ArneGleason/clive-dispenser/renders/cutaway_open.png

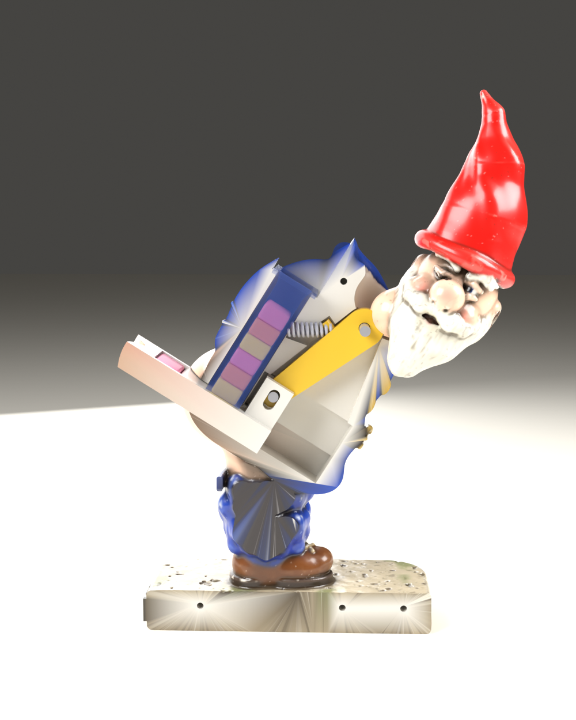
renders/cutaway_open.png
