ArneGleason/clive-dispenser/renders/cutaway_rest.png

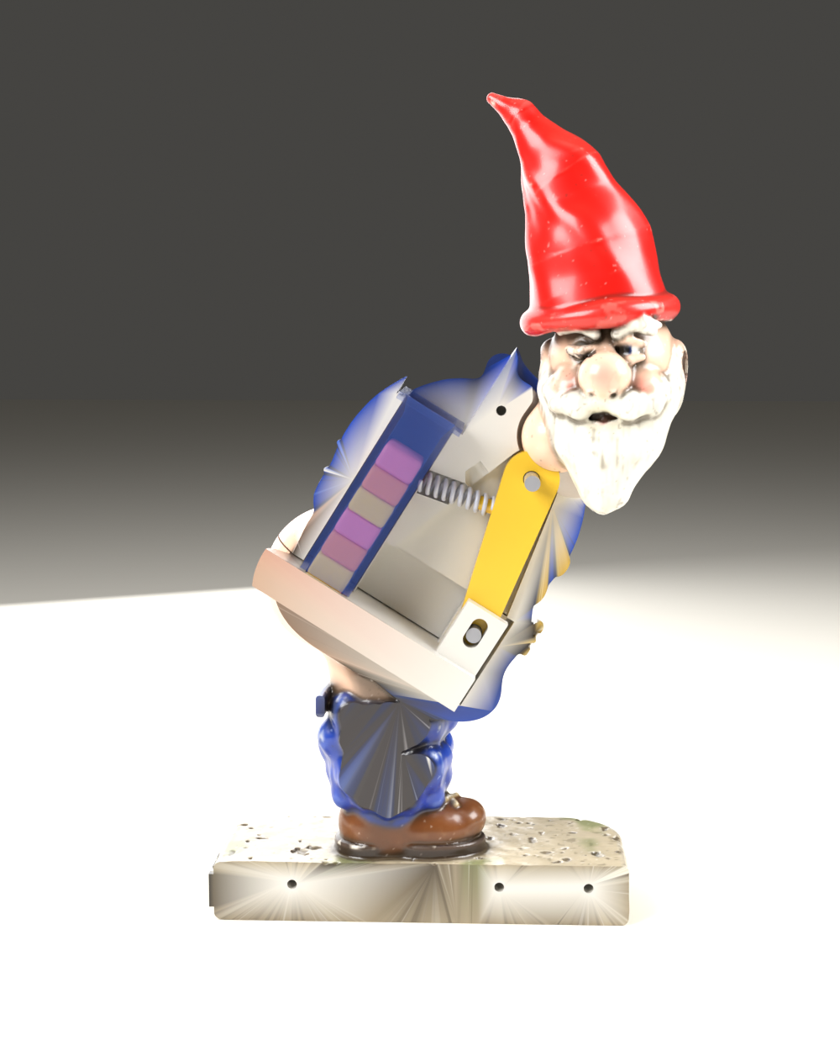
renders/cutaway_rest.png
