ArneGleason/clive-dispenser/renders/face.png

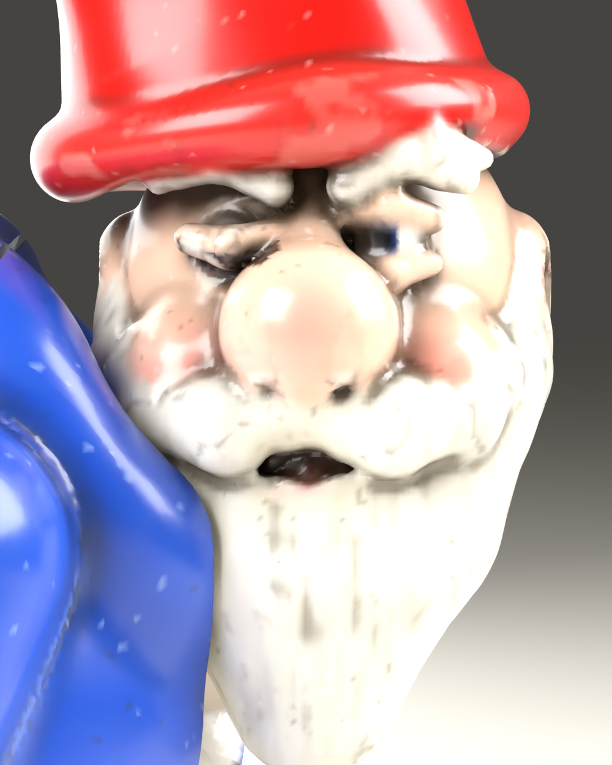
renders/face.png
