ArneGleason/clive-dispenser/renders/front_closed.png

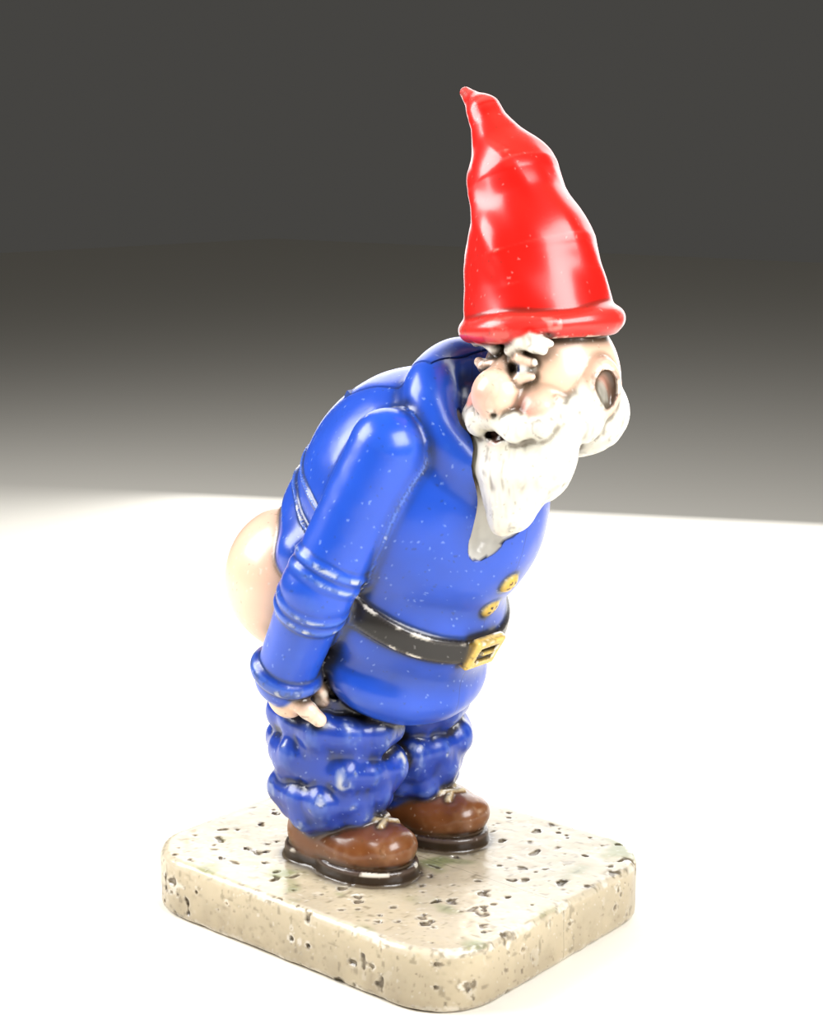
renders/front_closed.png
