ArneGleason/clive-dispenser/renders/hero_closed.png

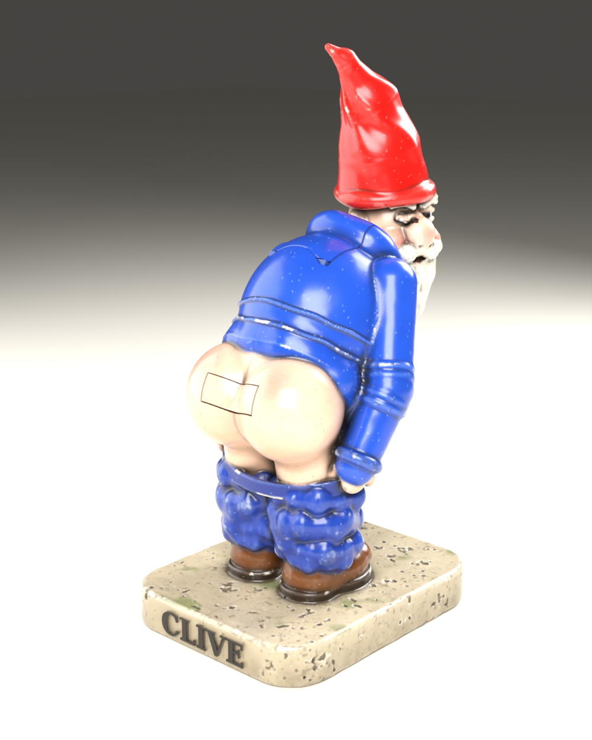
renders/hero_closed.png
