ArneGleason/clive-dispenser/renders/hero_open.png

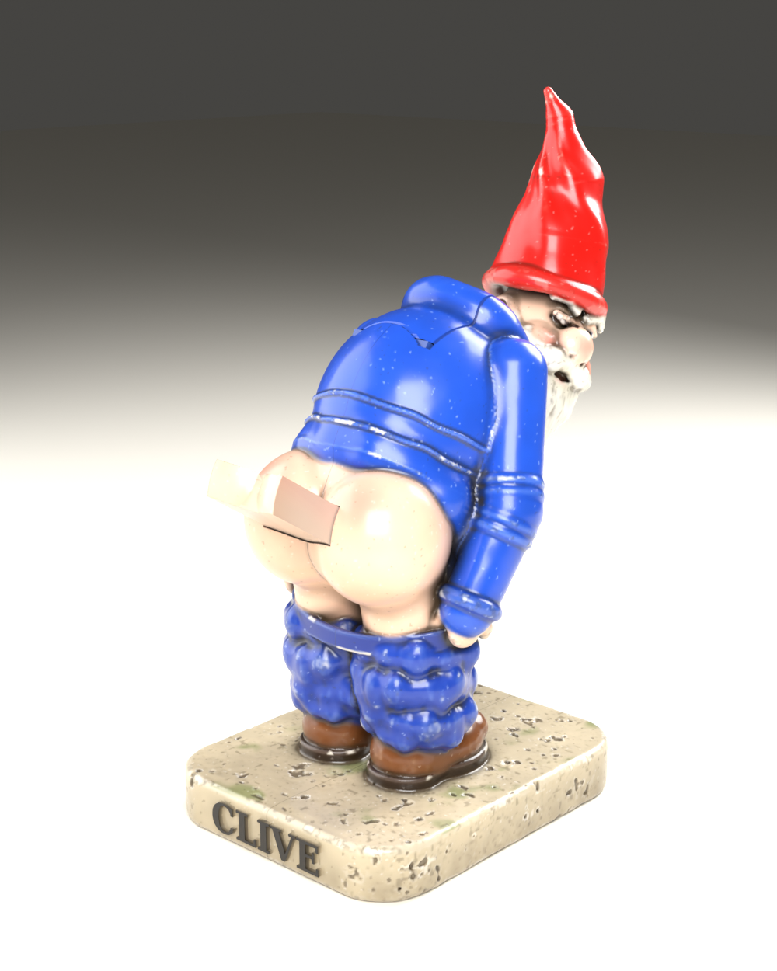
renders/hero_open.png
