ArneGleason/clive-dispenser/renders/plinth.png

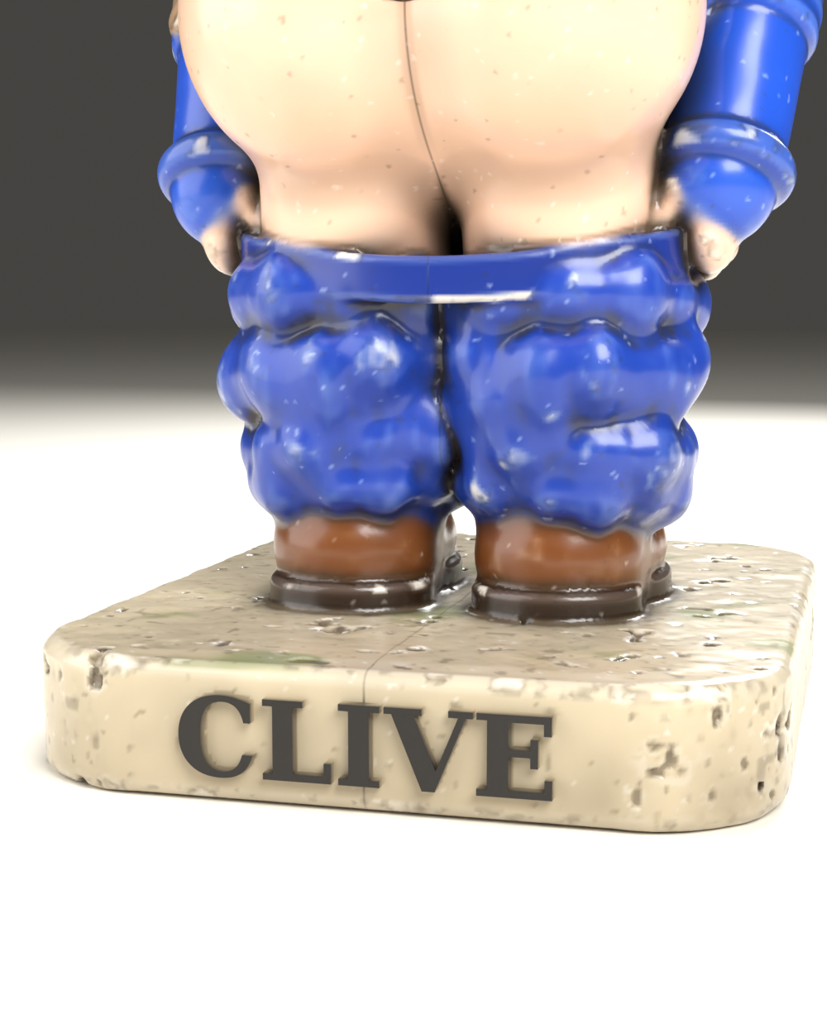
renders/plinth.png
