ArneGleason/clive-dispenser/assets/clive_text.stl

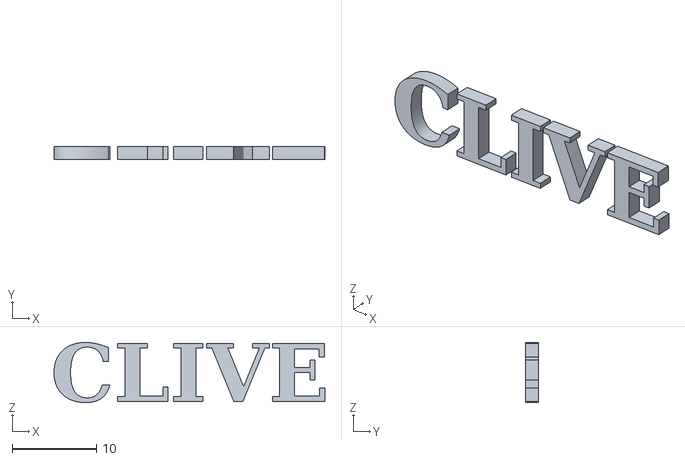
[picture p9: CAD file, 2026-10-11]
assets/clive_text.stl
32.2 x 1.60 x 7.15
