ArneGleason/clive-dispenser/colour/full/head.3mf

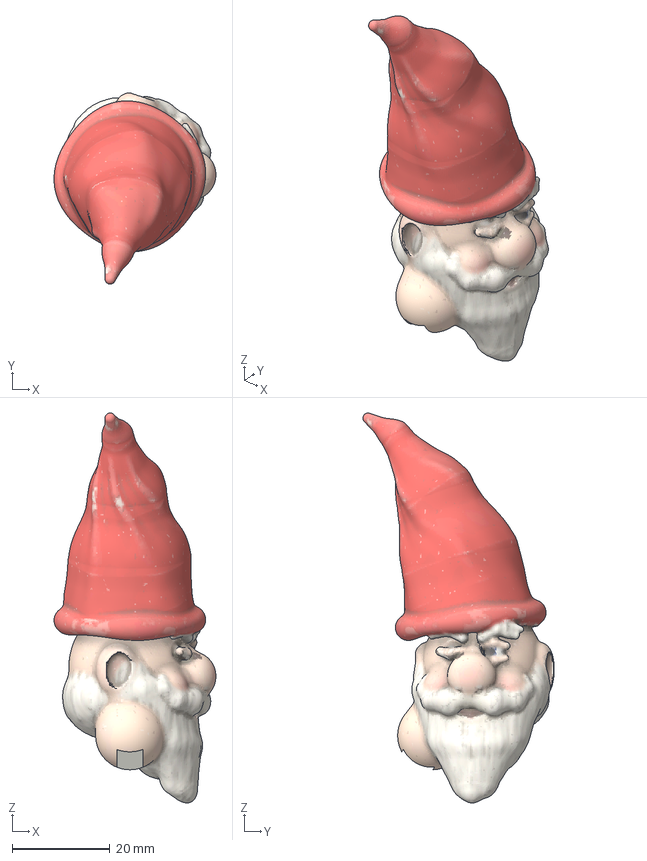
[picture p10: CAD file, 2026-10-11]
colour/full/head.3mf
33.1 x 39.1 x 79.8 mm
