ArneGleason/clive-dispenser/stl/refill_lid.stl

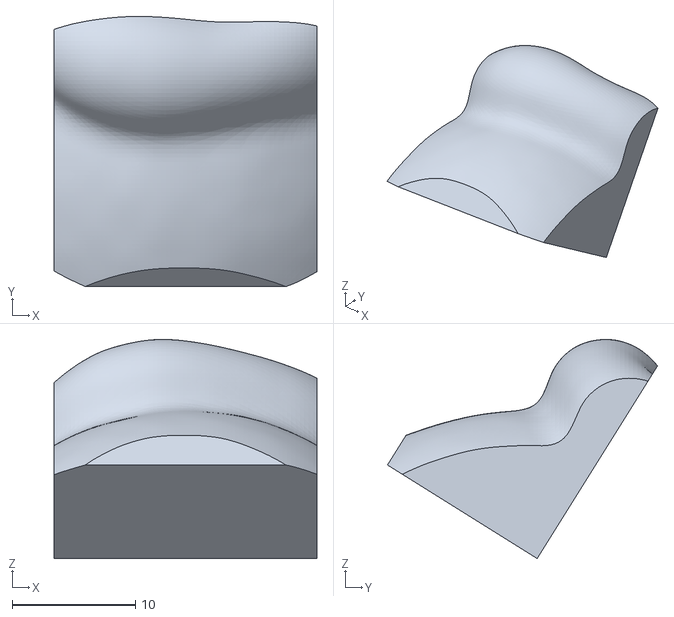
[picture p11: CAD file, 2026-10-11]
stl/refill_lid.stl
21.3 x 21.9 x 17.7
