ArneGleason/clive-dispenser/colour/full/tray_tictac.3mf

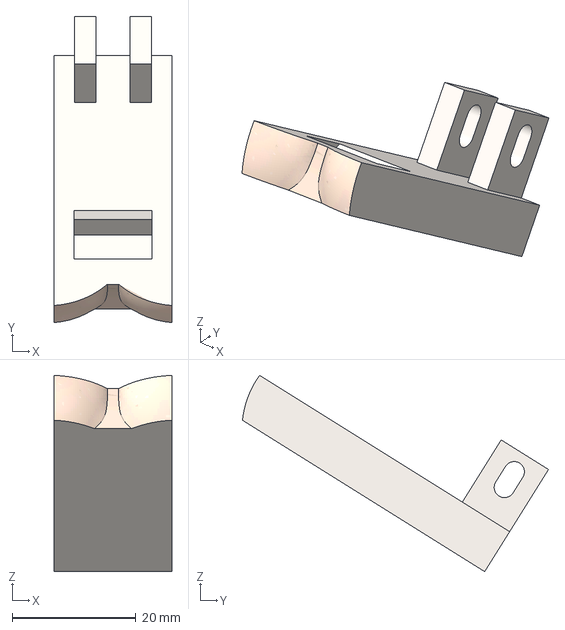
[picture p12: CAD file, 2026-10-11]
colour/full/tray_tictac.3mf
19.0 x 49.4 x 31.7 mm
