ArneGleason/clive-dispenser/stl/axle_3mm_optional.stl

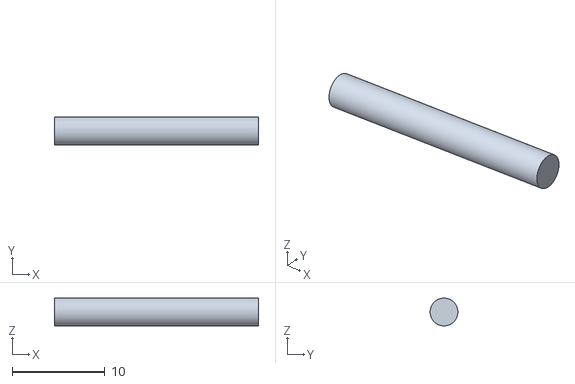
[picture p13: CAD file, 2026-10-11]
stl/axle_3mm_optional.stl
22.0 x 3.00 x 3.00
