ArneGleason/clive-dispenser/stl/hopper_tictac.stl

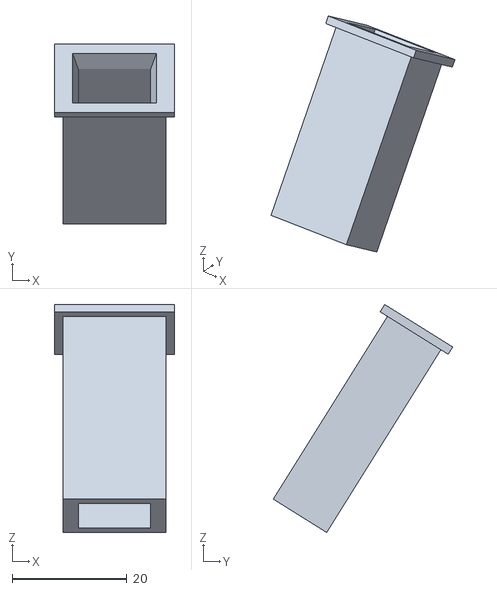
[picture p14: CAD file, 2026-10-11]
stl/hopper_tictac.stl
21.0 x 31.3 x 39.8
