ArneGleason/clive-dispenser/colour/full/body_right.3mf

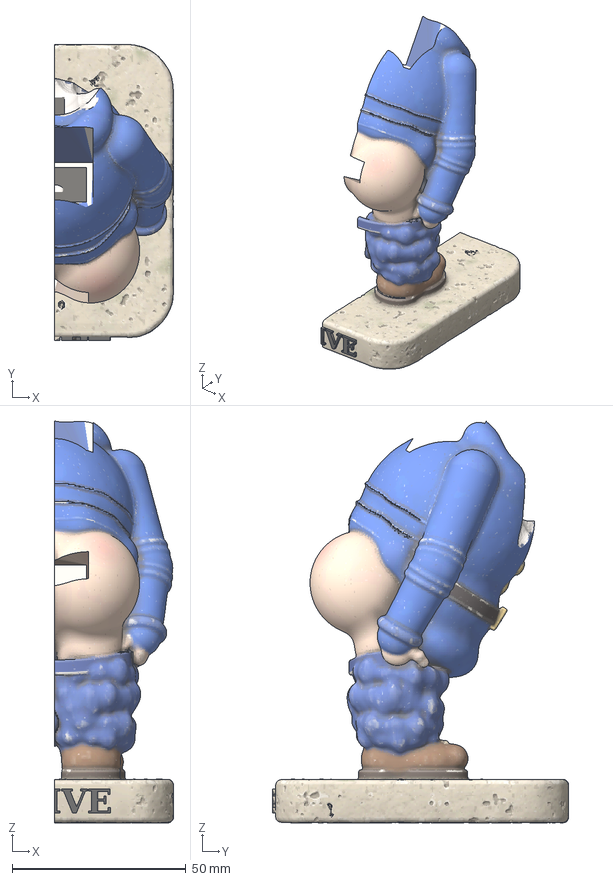
[picture p15: CAD file, 2026-10-11]
colour/full/body_right.3mf
34.3 x 85.3 x 115.6 mm
