ArneGleason/clive-dispenser/stl/tray_pin_3mm_optional.stl

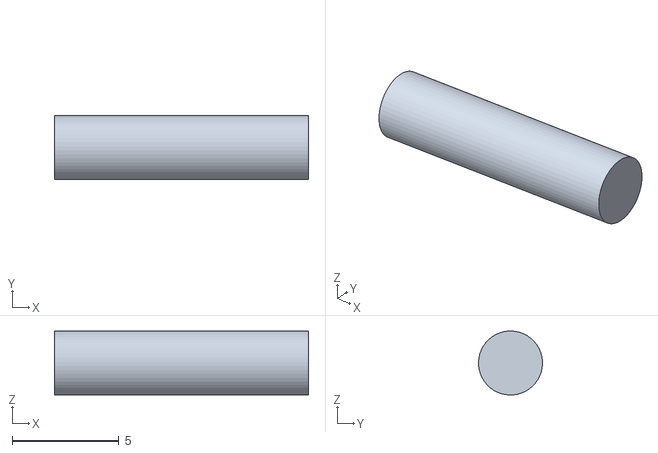
[picture p16: CAD file, 2026-10-11]
stl/tray_pin_3mm_optional.stl
11.9 x 3.00 x 3.00
