ArneGleason/clive-dispenser/stl/hopper_pez.stl

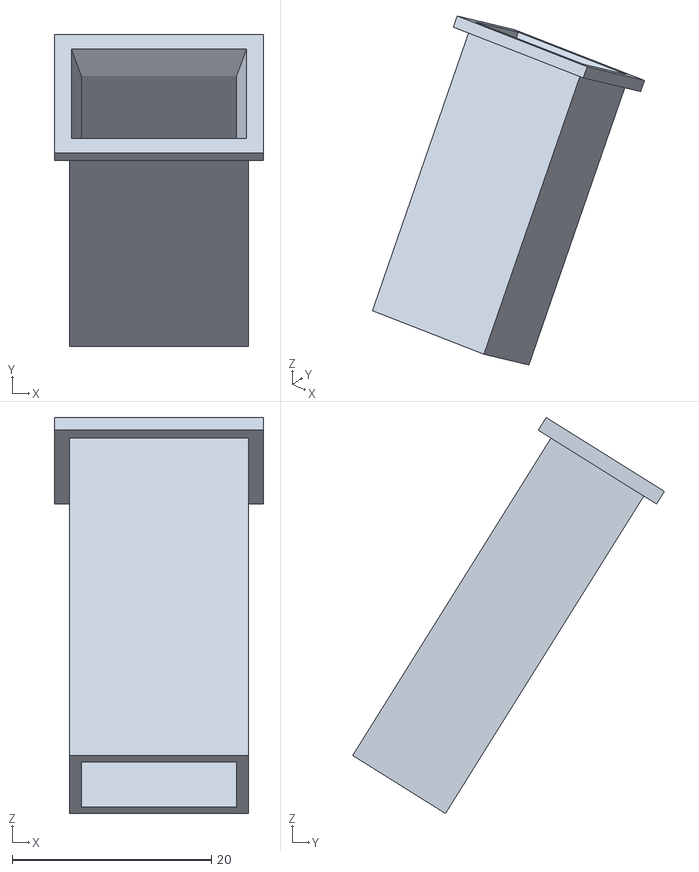
[picture p17: CAD file, 2026-10-11]
stl/hopper_pez.stl
21.0 x 31.3 x 39.8
