ArneGleason/clive-dispenser/stl/lever.stl

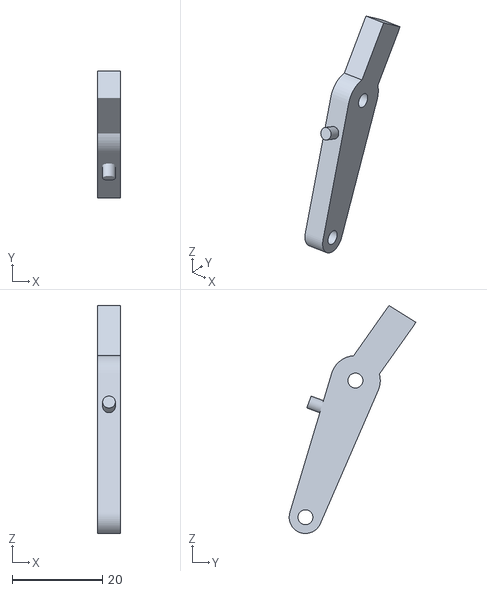
[picture p18: CAD file, 2026-10-11]
stl/lever.stl
5.00 x 28.0 x 50.4
