ArneGleason/clive-dispenser/(list of files, cad)

Other CAD files:
colour/full/tray_pez.3mf
stl/tray_pez.stl
colour/full/refill_lid.3mf
stl/head.stl
colour/full/body_left.3mf
stl/tray_tictac.stl
stl/body_left.stl
stl/body_right.stl
