ArneGleason/clive-dispenser/(commit log)

2026-10-11 Add Clive v1: printable mooning-gnome candy dispenser (untested)
    Tip his head forward and a tray slides out of his bum with one sweet on it.
    Hoppers and trays for Pez-style bricks and Tic Tacs. Parametric source
    (SDF sculpt + manifold3d mechanism), STL print files, renders and a
    virtual-test report (25/25 checks). Public domain under CC0 1.0.
    Claude-Session: https://claude.ai/code/session_0192UW7HJrB6Z1KxPLVfkchP
    [axle_3mm_optional.stl, body_left.stl, body_right.stl, clive_text.stl, head.stl, hopper_pez.stl, hopper_tictac.stl, lever.stl]
2026-10-11 Clive v2: detailed classic-gnome sculpt and full-colour paint job
    Exterior:
    - Head: beard of flowing locks with hair texture, curled handlebar
    moustache, arched brows, bulbous nose, cheek apples, hollowed ears,
    one open eye and a wink, a grin; creased, drooping hat with a rolled brim.
    - Body: jacket with collar, belt and buckle, buttons, cuffs, elbow creases,
    stitched elbow patch and a rumpled hitched-up hem; hands with fingers
    gripping the dropped trousers' waistband; bunched trouser folds; boots
    with soles, laces and a bow.
    - Stone plinth with CLIVE raised on its front edge, as in the ad.
    Colour printing:
    - Paint computed from the same distance fields: exaggerated occlusion and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
    [body_left.3mf, body_left.stl, body_right.3mf, body_right.stl, clive_text.stl, head.3mf, head.stl, refill_lid.3mf]
